HexabitzPlatform/H1DR5x-Hardware/README.md

# H1DR5x-Hardware
Hexabitz 10Base-T Ethernet Module Hardware Design
