HexabitzPlatform/H1DR5x-Hardware/H1DR51/Released/BOM/H1DR51.xlsx

 |  | www.hexabitz.com info@hexabitz.com |  |  | Bill Of Materials
Customer | Hexabitz | Revision | 1
Project | Hexabitz Modules | Date | 2022-08-03
Board | 10Base-T Ethernet-SPI (H1DR51) | Notes
Designator | Description | Manufacturer | Manufacturer Part Number | Octopart Url | Quantity
JP1 | Conn Unshrouded Header HDR 4 POS Solder ST Top Entry Thru-Hole Carton | TE Connectivity | 826925-2 | https://octopart.com/826925-2-te+connectivity-41144981?r=sp | 1
C1, C4, C6, C7, C10, C11, C13, C14, C15, C16 | CAP CER 0.1 UF 10% X7R 0603 | KEMET | C0603C104K8RACTU | https://octopart.com/c0603c104k8ractu-kemet-145075?r=sp&s=9bS9ASSwSEqMCE9KBEQZ0g | 10
C2 | CAP CER 1 UF 16V X7R 0805 | YAGEO [VA] | CC0805KKX7R7BB105 | https://octopart.com/cc0805kkx7r7bb105-yageo-8376555?r=sp | 1
C5, C8, C17 | CAP TANT 4.7 UF 10V 20% 0805 | Panasonic | 10TPU4R7MSI | https://octopart.com/10tpu4r7msi-panasonic-29487748?r=sp | 3
C12 | Cap Tant Solid 10uF 10V A CASE 10% (3.2 X 1.6 X 1.6mm) SMD 3216-18 3.8 Ohm 125C T/R | KEMET | T491A106K010AT | https://octopart.com/t491a106k010at-kemet-103782?r=sp | 1
C19, C20 | 0603 18 pF 50 V ±5% Tol. C0G/NP0 Surface Mount Multilayer Ceramic Capacitor | AXV | '06035A180JAT2A | https://octopart.com/06035a180jat2a-avx-39513095?r=sp | 2
R1, R12, R13 | Thick Film Resistors - SMD 0603 270 Ohm 5% Tol | Panasonic | ERJ-3GEYJ271V | https://octopart.com/erj-3geyj271v-panasonic-55560546?r=sp | 3
R2 | RES 10K Ohm 5% 0603 | Vishay | CRCW060310K0JNEB | https://octopart.com/crcw060310k0jneb-vishay-46603269 | 1
R4, R5, R6 | RES SMD 4.7K OHM 5% 1/10W 0603 | Vishay | CRCW06034K70JNEA | https://octopart.com/crcw06034k70jnea-vishay-39855920 | 3
R7, R8, R9, R10 | Res Thick Film 0603 49.9 Ohm 1% 0.1W(1/10W) ±100ppm/C Molded SMD Paper T/R | Vishay | CRCW060349R9FKEC | https://octopart.com/crcw060349r9fkec-vishay-46606116 | 4
R11 | RES SMD 2.32K OHM 1% 1/10W 0603 | Vishay | CRCW06032K32FKEA | https://octopart.com/crcw06032k32fkea-vishay-39845673 | 1
FB1, FB2 | Ind chip Bead Multi-Layer 30 ohms 25% 100MHZ Ferrite 1,5A 0603Punched paper T/R | TDK | MMZ1608Y300BTA00 | https://octopart.com/mmz1608y300bta00-tdk-7906990?r=sp | 1
U1 | MCU 32-Bit ARM Cortex-M0+ RISC 512kByte Flash 1.7V to 3.6V 48-Pin UFQFPN Tray | STMicroelectronics | STM32G0B1CEU6N | https://octopart.com/stm32g0b1ceu6n-stmicroelectronics-116364672?r=sp | 2
U2 | Stand-Alone Ethernet Controller with SPI Interface, 28-Pin SSOP | Microchip | ENC28J60/SS | https://octopart.com/enc28j60%2Fss-microchip-454926 | 1
J1 | Conn Magjack 1port 100 Base-t | Würth Elektronik | 74980111211 | http://octopart.com/74980111211-w%C3%BCrth+elektronik-25916022 | 1
D1 | Red 0603 130° Clear 54 mcd 2 V Surface Mount ChipLED | Vishay | VLMS1300-GS08 | https://octopart.com/vlms1300-gs08-vishay-21709201?r=sp&s=0nXJNjGsSbWwqfqWlZv0EA | 1
X1 | 8,0000MHZ 33pF SMD MURATA Resonators | Murata | CSTNE8M00G550000R0 | https://octopart.com/cstne8m00g550000r0-murata-91406934?r=sp | 1
X2 | Crystal 25MHz ±20ppm (Tol) ±50ppm (Stability) 18pF FUND 50Ohm 2-Pin CSMD T/R | Abracon | ABM3-25.000MHZ-B2-T | http://octopart.com/abm3-25.000mhz-b2-t-abracon-102716 | 1
