HexabitzPlatform/H1DR5x-Hardware/H1DR51/Documentation/H1DR51.pdf

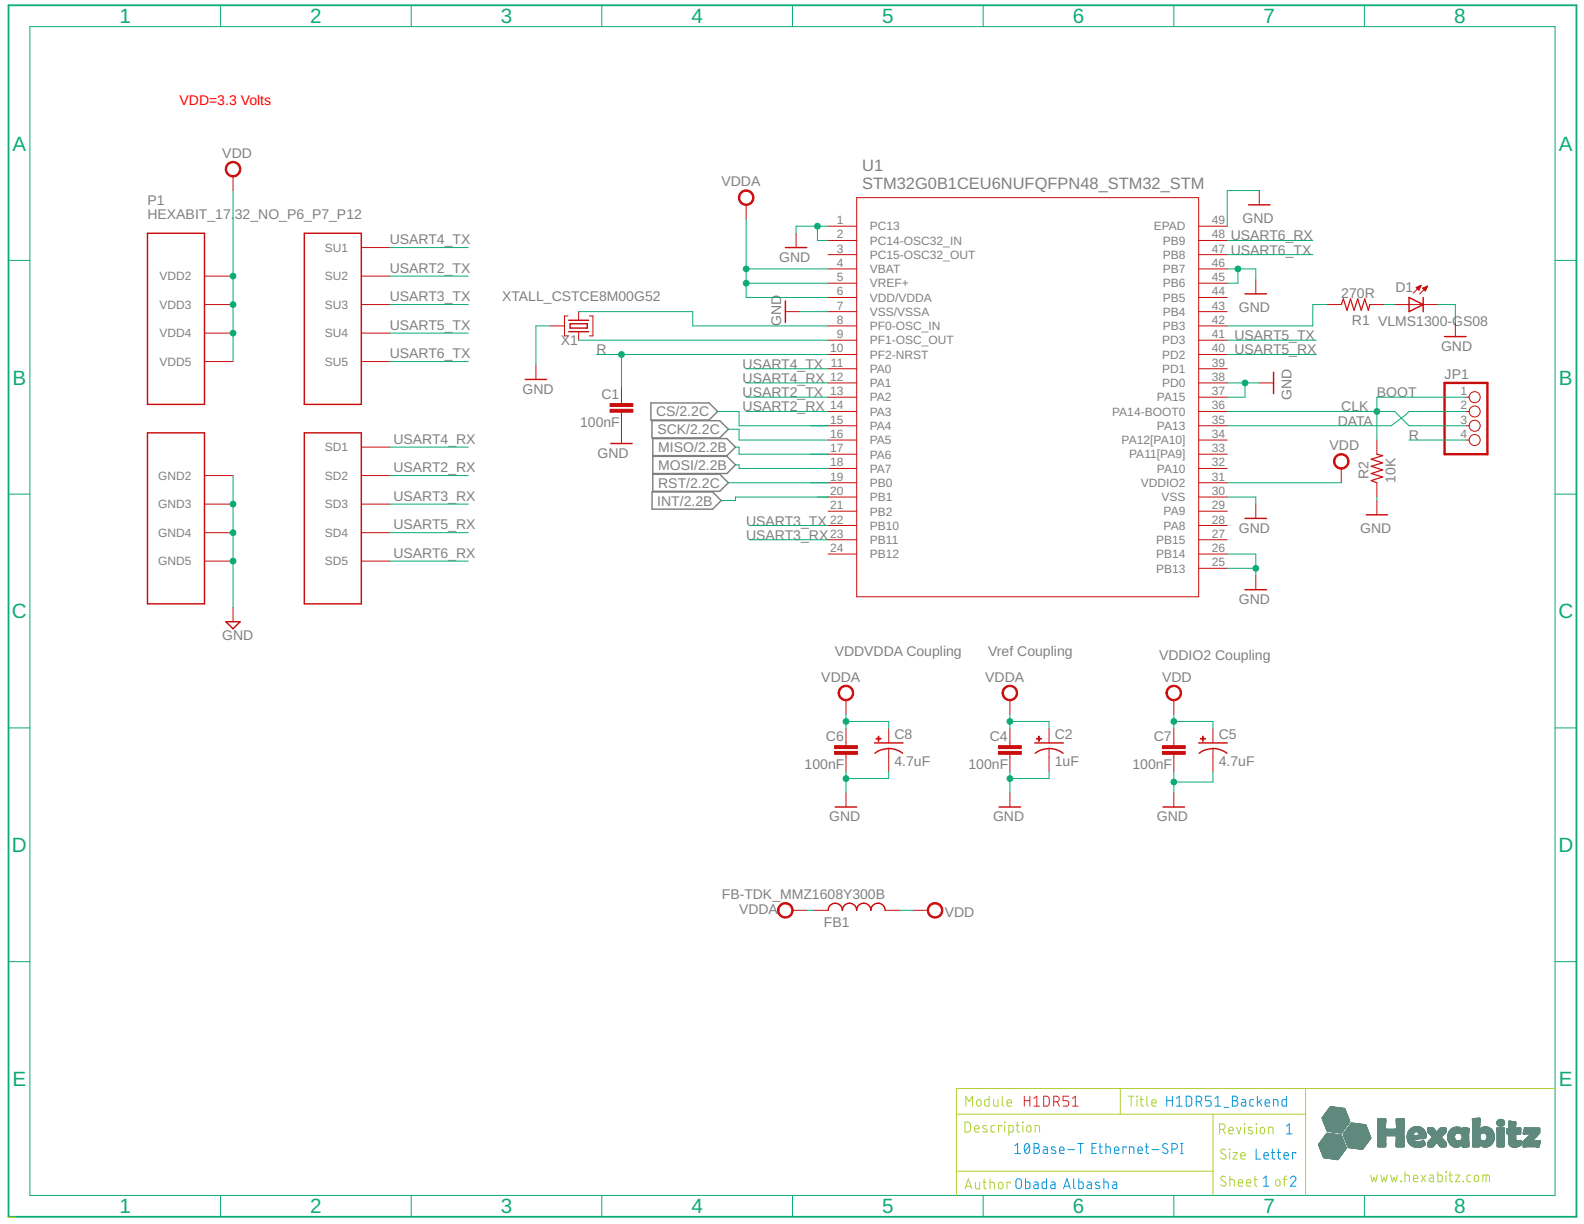
[picture p1: page 1]

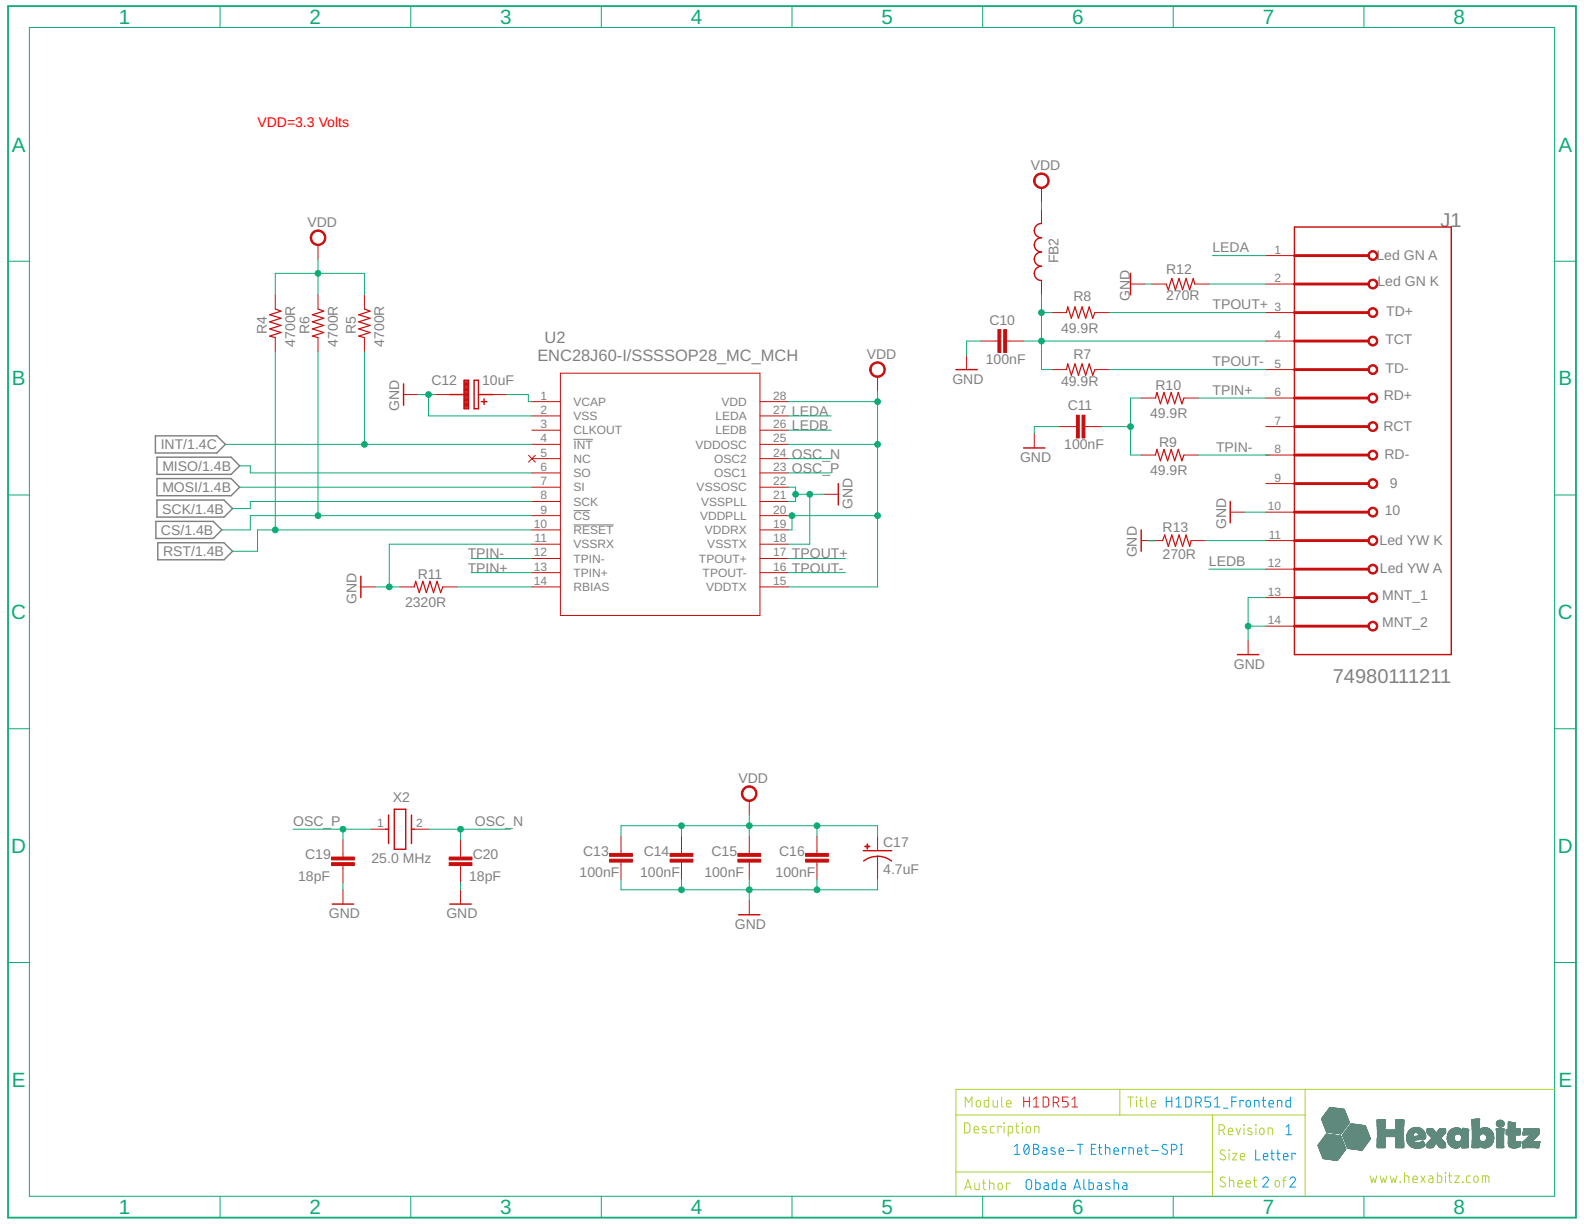
[picture p2: page 2]
