HexabitzPlatform/H1DR5x-Hardware/H1DR51/Design/H1DR51.brd

## EAGLE design H1DR51/Design/H1DR51.brd (2022-08-23)

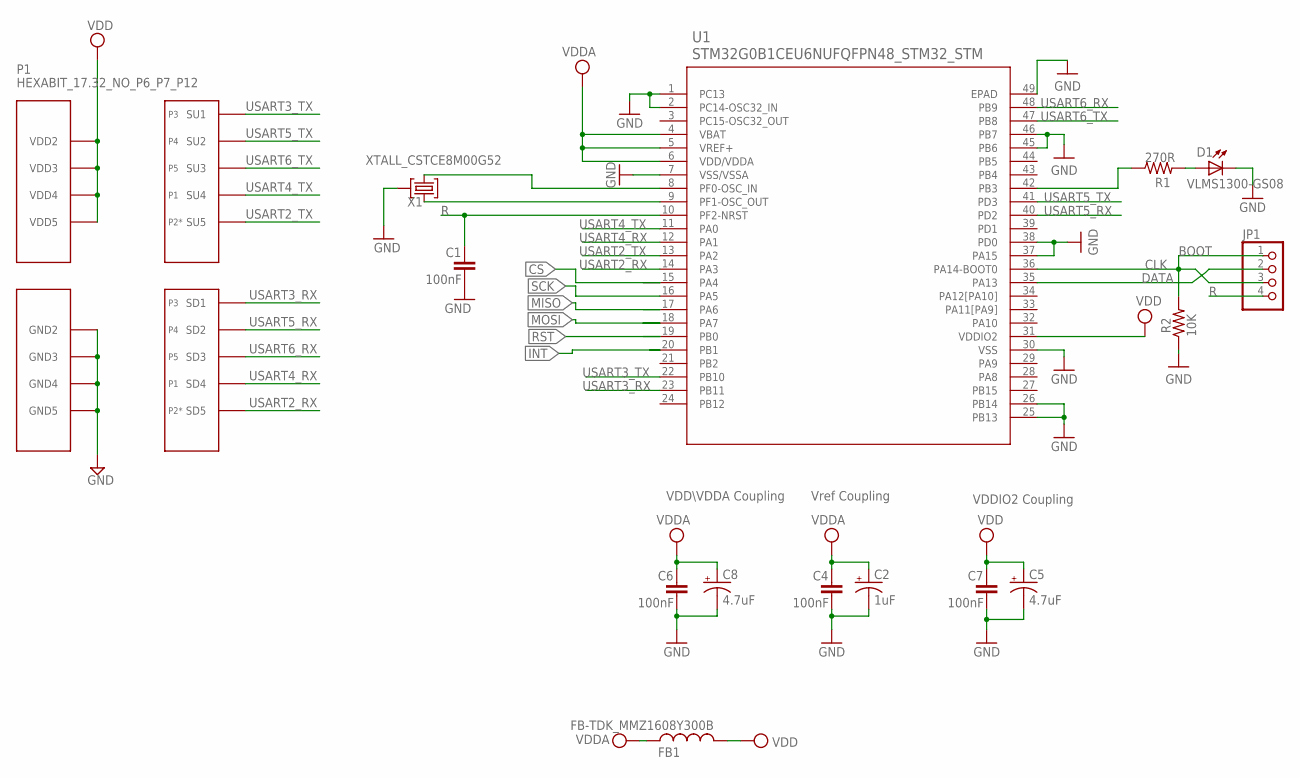
[picture p3: schematic H1DR51.sch, sheet 1]

Parts:
C1, C4, C6, C7: 100nF; C-0603
C2: 1uF; C-0805-POL
C5, C8: 4.7uF; C-0805-POL
D1: VLMS1300-GS08; MPN VLMS1300-GS08
FB1: FB-TDK_MMZ1608Y300B; MPN MMZ1608Y300B
JP1: PINHD-1X4; 1X04
P1: HEXABIT_17.32_NO_P6_P7_P12
R1: 270R; R-0603
R2: 10K; R-0603
U1: STM32G0B1CEU6NUFQFPN48_STM32_STM; UFQFPN48_STM32_STM
X1: XTALL_CSTCE8M00G52

Connections:
CLK: JP1.1, JP1.3, R2.2, U1.36 (PA14-BOOT0)
CS: U1.15 (PA4); also elsewhere on the board
DATA: JP1.2, U1.35 (PA13)
GND: C1.2, C2.2 (-), C4.2, C5.2 (-), C6.2, C7.2, C8.2 (-), D1.C, P1.PAD_PD8 (GND2), P1.PAD_PD9 (GND3), P1.PAD_PD10 (GND4), P1.PAD_PD11 (GND5), R2.1, U1.1 (PC13), U1.2 (PC14-OSC32_IN), U1.7 (VSS/VSSA), U1.25 (PB13), U1.26 (PB14), U1.30 (VSS), U1.37 (PA15), U1.38 (PD0), U1.45 (PB6), U1.46 (PB7), U1.49 (EPAD), X1.P$2 (2); also elsewhere on the board
INT: U1.20 (PB1); also elsewhere on the board
MISO: U1.17 (PA6); also elsewhere on the board
MOSI: U1.18 (PA7); also elsewhere on the board
unnamed: R1.1, U1.42 (PB3)
unnamed: D1.A, R1.2
unnamed: U1.9 (PF1-OSC_OUT), X1.P$1 (1)
unnamed: U1.8 (PF0-OSC_IN), X1.P$3 (3)
R: C1.1, JP1.4, U1.10 (PF2-NRST)
RST: U1.19 (PB0); also elsewhere on the board
SCK: U1.16 (PA5); also elsewhere on the board
USART2_RX: P1.PAD_PD5 (SD5), U1.14 (PA3)
USART2_TX: P1.PAD_PU5 (SU5), U1.13 (PA2)
USART3_RX: P1.PAD_PD1 (SD1), U1.23 (PB11)
USART3_TX: P1.PAD_PU1 (SU1), U1.22 (PB10)
USART4_RX: P1.PAD_PD4 (SD4), U1.12 (PA1)
USART4_TX: P1.PAD_PU4 (SU4), U1.11 (PA0)
USART5_RX: P1.PAD_PD2 (SD2), U1.40 (PD2)
USART5_TX: P1.PAD_PU2 (SU2), U1.41 (PD3)
USART6_RX: P1.PAD_PD3 (SD3), U1.48 (PB9)
USART6_TX: P1.PAD_PU3 (SU3), U1.47 (PB8)
VDD: C5.1 (+), C7.1, FB1.2, P1.PAD_PU8 (VDD2), P1.PAD_PU9 (VDD3), P1.PAD_PU10 (VDD4), P1.PAD_PU11 (VDD5), U1.31 (VDDIO2); also elsewhere on the board
VDDA: C2.1 (+), C4.1, C6.1, C8.1 (+), FB1.1, U1.4 (VBAT), U1.5 (VREF+), U1.6 (VDD/VDDA)

Notes on the sheet:
Vref Coupling
VDDIO2 Coupling
VDD\VDDA Coupling
BOOT
P2*

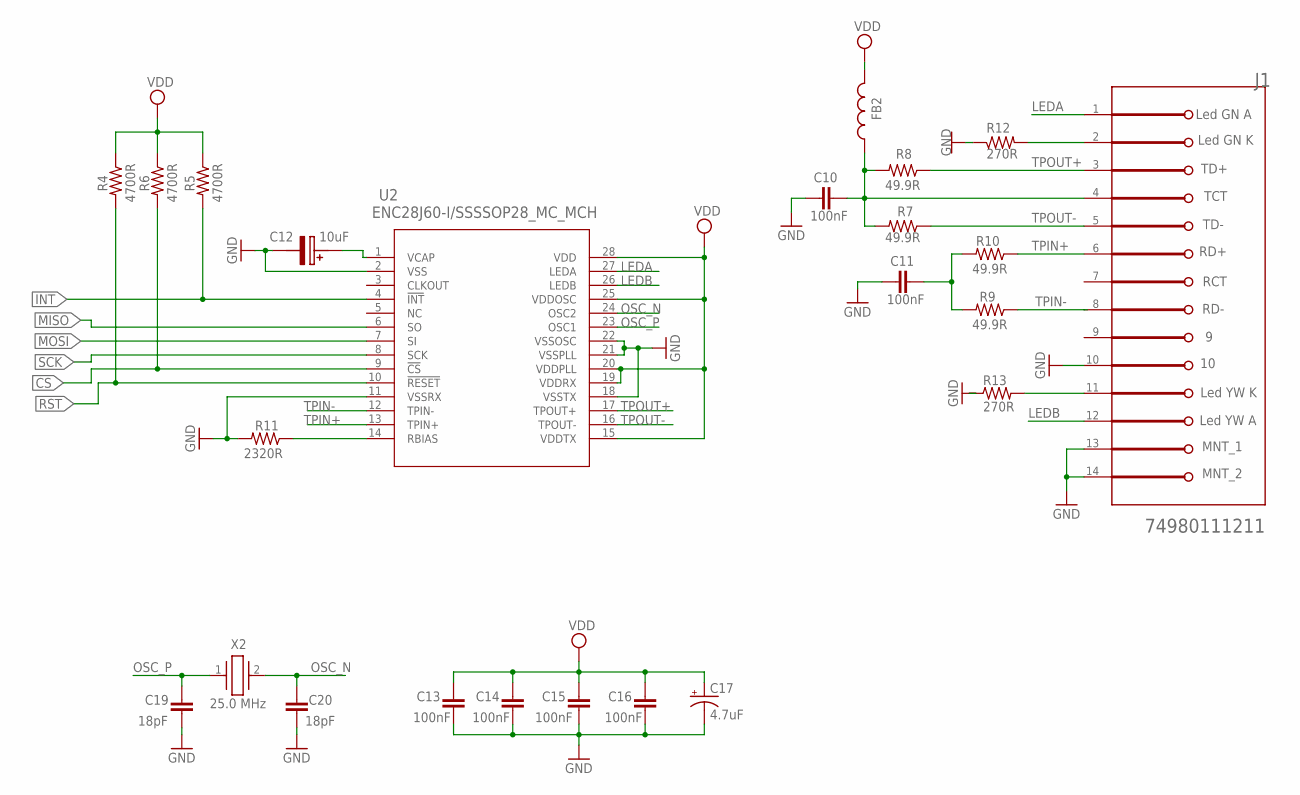
[picture p4: schematic H1DR51.sch, sheet 2]

Parts:
C10, C11, C13, C14, C15, C16: 100nF; C-0603
C12: 10uF; T491A
C17: 4.7uF; C-0805-POL
C19, C20: 18pF; C-0603
FB2: FB-TDK_MMZ1608Y300B; MPN MMZ1608Y300B
J1: WURTH_74980111211WURTH_74980111211_0_0; WURTH_74980111211_0
R4, R5, R6: 4700R; R-0603
R7, R8, R9, R10: 49.9R; R-0603
R11: 2320R; R-0603
R12, R13: 270R; R-0603
U2: ENC28J60-I/SSSSOP28_MC_MCH; SSOP28_MC_MCH
X2: 25.0 MHz; ABM325000MHZB2T

Connections:
CS: R6.2, U2.9 (!CS); also elsewhere on the board
GND: C10.2, C11.2, C12.2 (-), C13.2, C14.2, C15.2, C16.2, C17.2 (-), C19.2, C20.2, J1.10, J1.13 (MNT_1), J1.14 (MNT_2), R11.2, R12.1, R13.1, U2.2 (VSS), U2.11 (VSSRX), U2.18 (VSSTX), U2.21 (VSSPLL), U2.22 (VSSOSC); also elsewhere on the board
INT: R5.2, U2.4 (!INT); also elsewhere on the board
LEDA: J1.1 (GREEN_ANODE), U2.27 (LEDA)
LEDB: J1.12 (YELLOW_ANODE), U2.26 (LEDB)
MISO: U2.6 (SO); also elsewhere on the board
MOSI: U2.7 (SI); also elsewhere on the board
unnamed: C11.1, R9.2, R10.2
unnamed: C10.1, FB2.1, J1.4 (TCT), R7.2, R8.2
unnamed: R11.1, U2.14 (RBIAS)
unnamed: C12.1 (+), U2.1 (VCAP)
unnamed: J1.2 (GREEN_CATHODE), R12.2
unnamed: J1.11 (YELLOW_CATHODE), R13.2
OSC_N: C20.1, U2.24 (OSC2), X2.2
OSC_P: C19.1, U2.23 (OSC1), X2.1
RST: R4.2, U2.10 (!RESET); also elsewhere on the board
SCK: U2.8 (SCK); also elsewhere on the board
TPIN+: J1.6 (RD+), R10.1, U2.13 (TPIN+)
TPIN-: J1.8 (RD-), R9.1, U2.12 (TPIN-)
TPOUT+: J1.3 (TD+), R8.1, U2.17 (TPOUT+)
TPOUT-: J1.5 (TD-), R7.1, U2.16 (TPOUT-)
VDD: C13.1, C14.1, C15.1, C16.1, C17.1 (+), FB2.2, R4.1, R5.1, R6.1, U2.15 (VDDTX), U2.19 (VDDRX), U2.20 (VDDPLL), U2.25 (VDDOSC), U2.28 (VDD); also elsewhere on the board

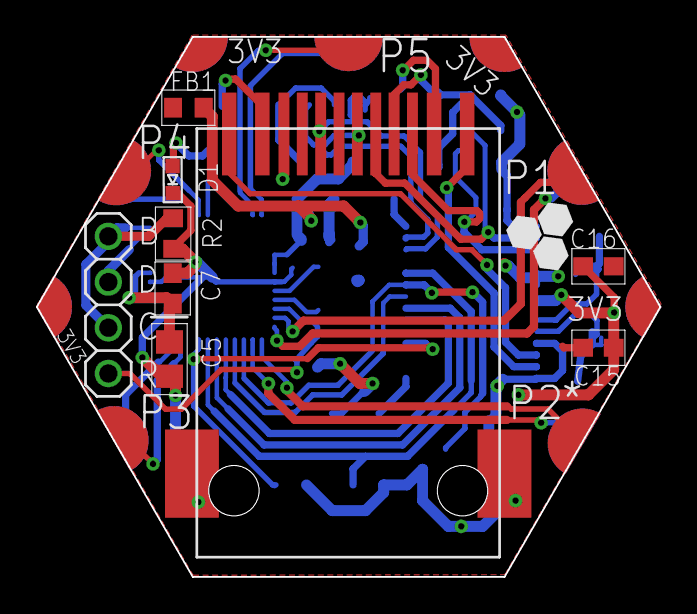
[picture p5: board H1DR51.brd from above]

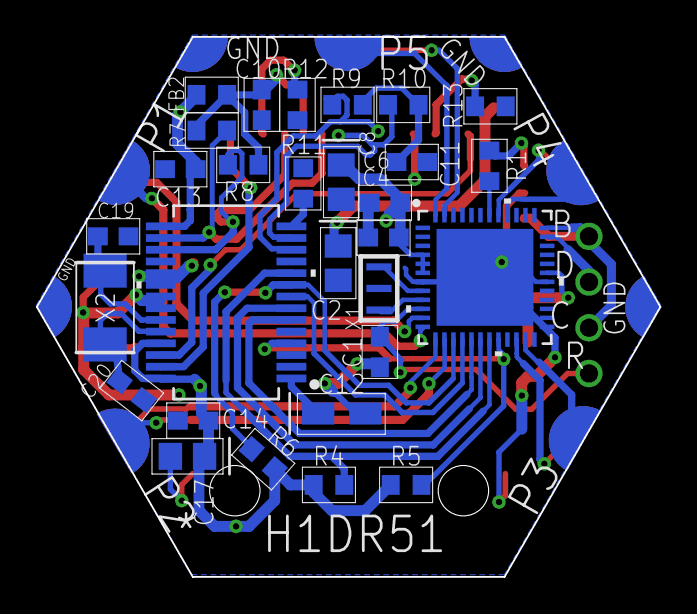
[picture p6: board H1DR51.brd from below]

Board: 2 copper layers, 34.6 x 30.0 mm, 39 parts (29 on the bottom side), 40 nets.
