HexabitzPlatform/H1DR5x-Hardware/(commit log)

2022-08-23 Changing MCU to STM32G0
    [H1DR51.brd, H1DR51.sch, H1DR51.xlsx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]
2023-02-15 -Correcting some documentaion issues
    [H1DR51.xlsx]
2023-03-05 -Correct some documentaion issues
    [H1DR51.sch]
